spEROwli/fridge-scale/(commit log)

2026-07-22 Fridge Scale MVP: calibrated Pico 2 W + HX711 load cell, BLE broadcast, web app
    - firmware/: MicroPython (BLE broadcast, USB reader, calibration, event FSM)
    - app/: Web Bluetooth client (static, Vercel-ready)
    - docs/: wiring, technical handoff, product strategy
    - calib.json: verified calibration (50 g ref, reads 49.4 g)
    [clip_design.scad]
2026-09-07 Add Pico serial mock without load cell
2026-09-07 Protect existing Pico startup script in mock workflow
